Ferflogo/birds_gst/README.md

Birds Network Ground Station Terminal, SETECLab's implementation
============

### Most recent version of this repository can be found in: ###

* [GitHub](https://github.com/Setec-Lab/birds_gst)

### What is this repository for? ###

* This repository was created to develop the SETECLab's implementation of the Birds Network Ground Station Terminal. 

### Board v2.7

* [Schematic](https://github.com/Setec-Lab/birds_gst/blob/dev/docs/GST_PCB_v2.7.pdf)
* [BOM](https://github.com/Setec-Lab/birds_gst/blob/dev/docs/Partlist_for_GST_PCB_v2.7.pdf)
* [Guide](https://github.com/Setec-Lab/birds_gst/blob/dev/docs/Guide_to_use_GST_PCB.pdf)

### DS18B20 Temp. Sensor

* [Datasheet](https://cdn.sparkfun.com/datasheets/Sensors/Temp/DS18B20.pdf) 
* [Implementation example](https://create.arduino.cc/projecthub/TheGadgetBoy/ds18b20-digital-temperature-sensor-and-arduino-9cc806)

### LM2830XMF/NOPB Step Down DC/DC Regulator

* [Datasheet](https://pdf1.alldatasheet.com/datasheet-pdf/view/753277/TI/LM2830XMF/NOPB.html)

### RF98
* [Datasheet](https://datasheetspdf.com/pdf-file/748004/HOPERF/RF98/1)

### Enclousure

### How do I get set up? ###

* Install Git
* Install Arduino IDE
* Install ESP32 Board in the Arduino Boards Manager
Open Arduino IDE, then Select `Tools`->`Board:`->`Boards Manager...`
Search `ESP32` and install it.
* Install Heltec ESP32 Library in the Arduino Library Manager
Open Arduino IDE, then Select `Sketch`->`Include Library`->`Manage Libraries...`
Search `Heltec ESP32` and install it.
* Install Adafruit MQTT Library in the Arduino Library Manager
Open Arduino IDE, then Select `Sketch`->`Include Library`->`Manage Libraries...`
Search `Adafruit MQTT` and install it.
* Install Adafruit MCP9600 Library in the Arduino Library Manager
Open Arduino IDE, then Select `Sketch`->`Include Library`->`Manage Libraries...`
Search `Adafruit MCP9600 Library` and install it.

### Contribution guidelines ###

* If you want to propose a review or need to modify the code for any reason first clone this [repository](https://github.com/DeltaLabo/caminos) in your PC and create a new branch for your changes. Once your changes are complete and fully tested ask the administrator permission to push this new branch into the source.
* If you just want to do local changes instead you can download a zip version of the repository and do all changes locally in your PC. 

### Who do I talk to? ###

* [Juan J. Rojas](mailto:juan.rojas@itcr.ac.cr)
* [Ian Coberly](mailto:cobjim28@gmail.com)
