Ferflogo/birds_gst/docs/GST_PCB_v2.7.pdf

0.1u | 22n

3.3uH

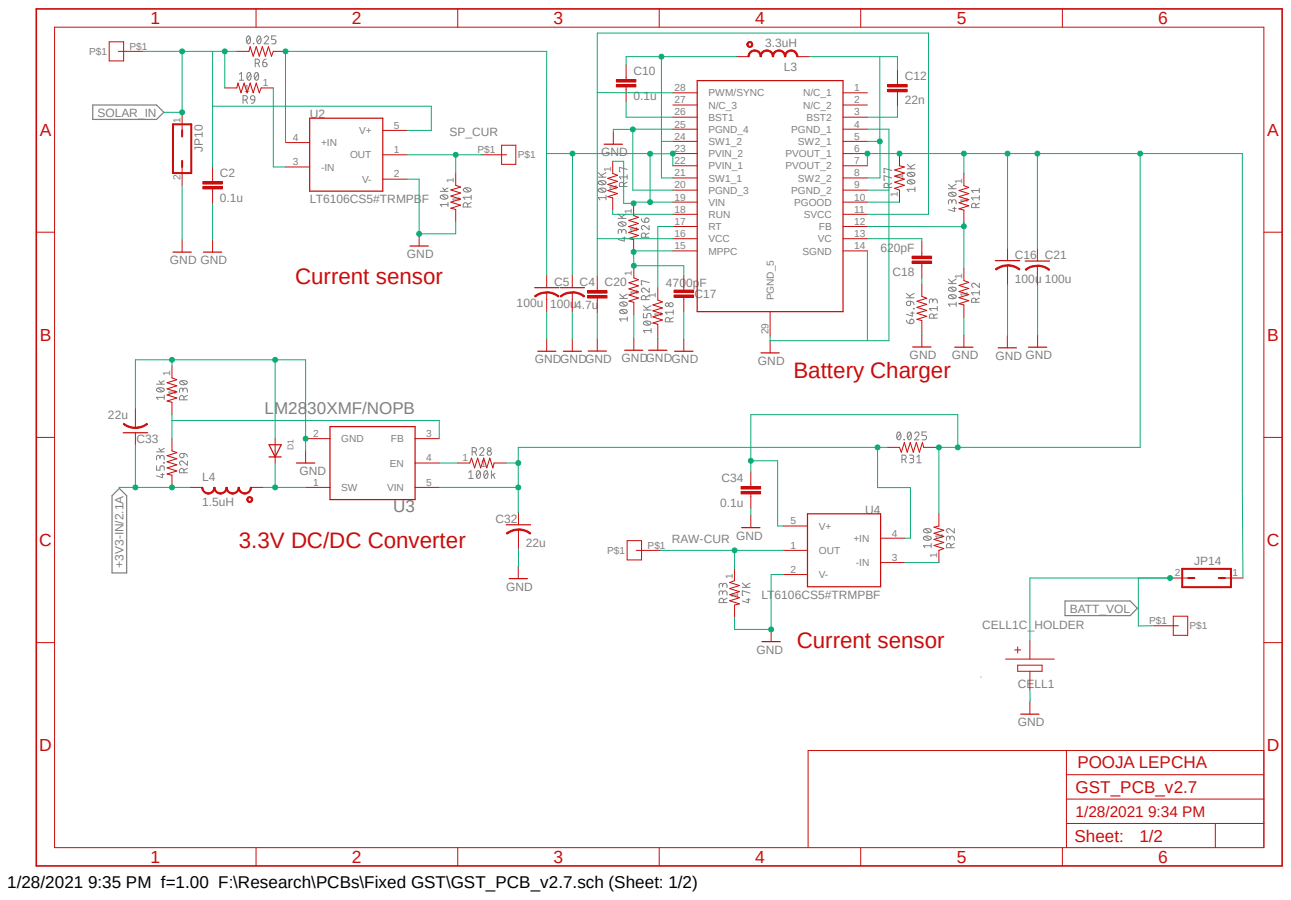
[picture p1: page 1]

1/28/2021 9:35 PM f=1.00 F:\Research\PCBs\Fixed GST\GST_PCB_v2.7.sch (Sheet: 1/2)

# Flash Memory

A

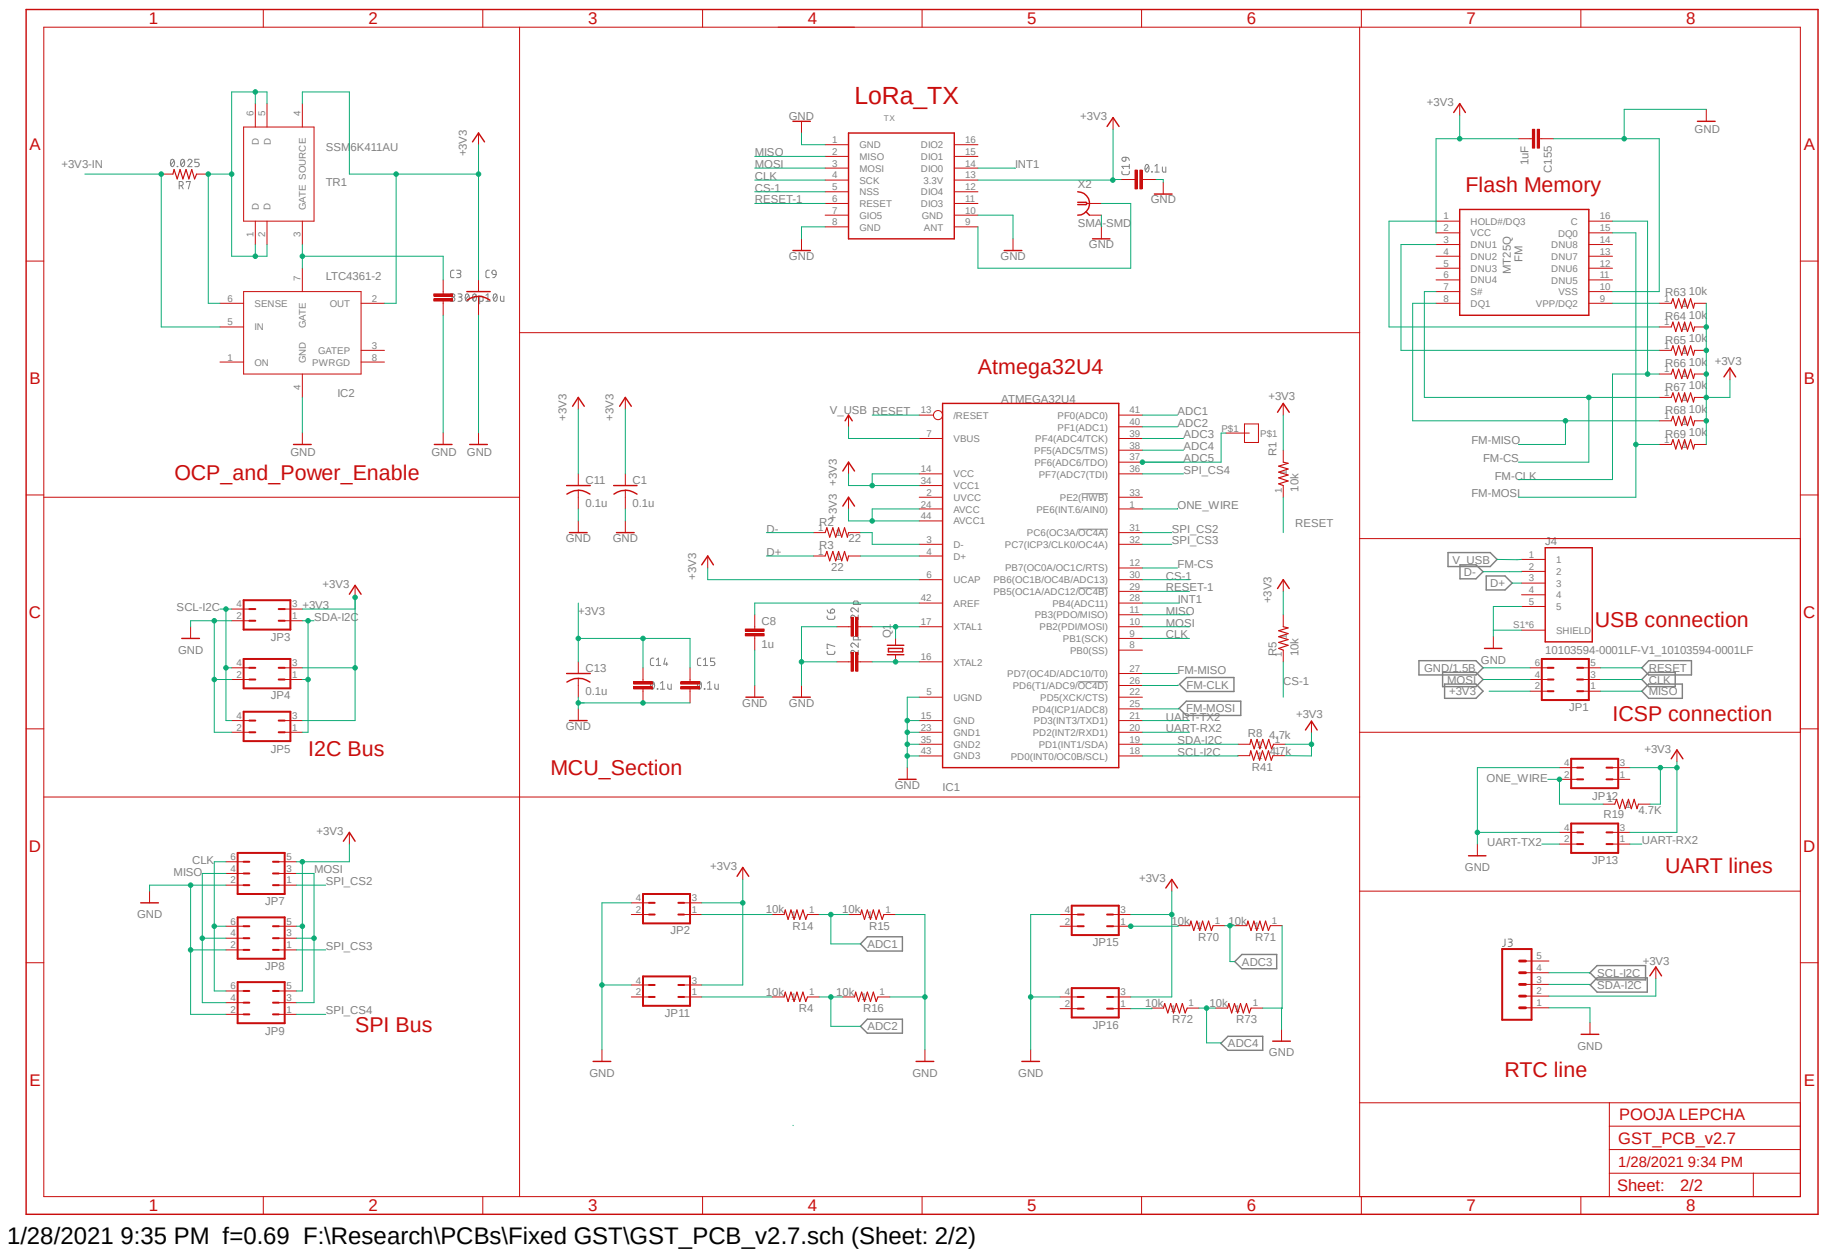
[picture p2: page 2]

LoRa_TX

1/28/2021 9:35 PM f=0.69 F:\Research\PCBs\Fixed GST\GST_PCB_v2.7.sch (Sheet: 2/2)
