Ferflogo/birds_gst/docs/Guide_to_use_GST_PCB.pdf

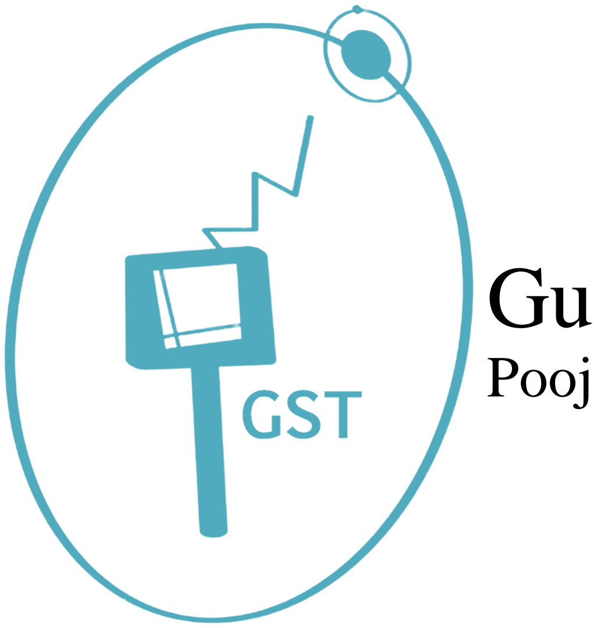
[picture p3: figure]

# Guide to Use GST PCB

## Pooja Lepcha

# What makes the GST PCB?

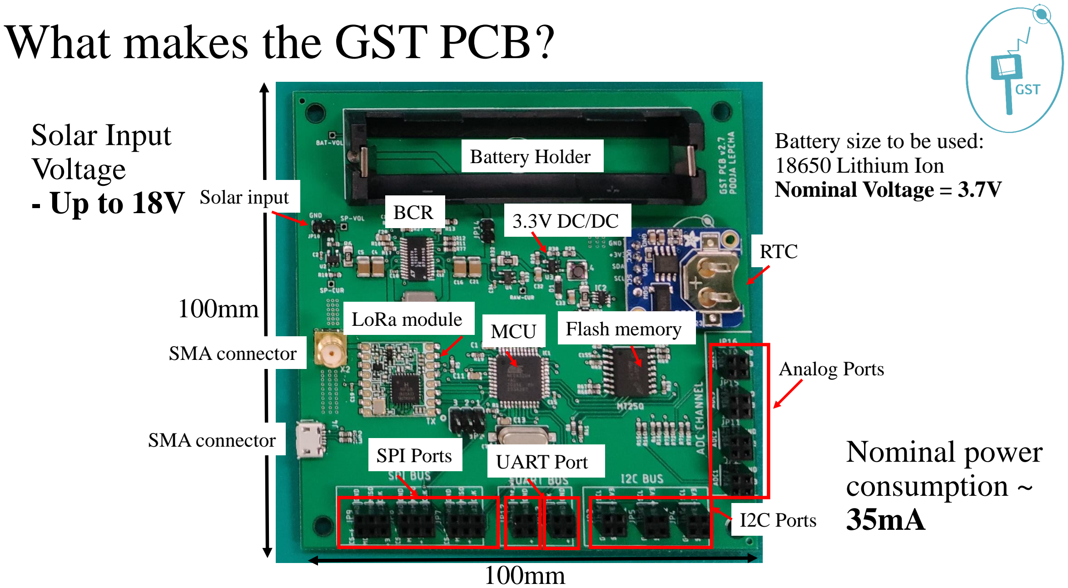
[picture p4: page 2]

100mm

100mm

Analog Ports

I2C Ports

UART Port SPI Ports

RTC

MCU LoRa module

BCR

Battery Holder

Flash memory

Solar input

Nominal power
consumption ~
35mA

3.3V DC/DC

Solar Input
Voltage
- Up to 18V

SMA connector

SMA connector

Battery size to be used:
18650 Lithium Ion
Nominal Voltage = 3.7V

# Lets look deeper…

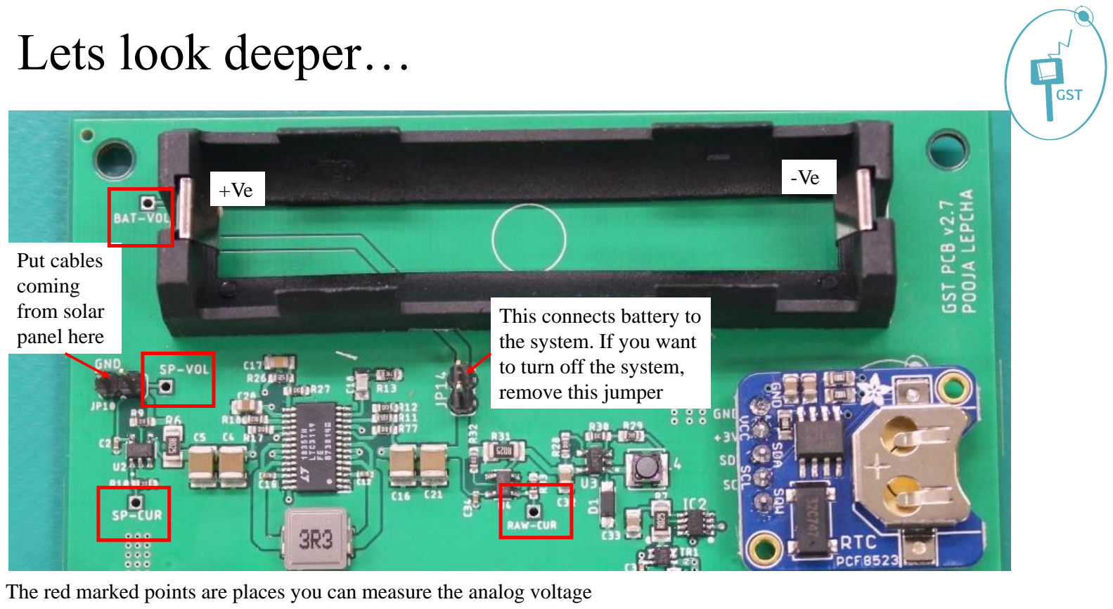
[picture p5: page 3]

Put cables
coming
from solar
panel here

-Ve

This connects battery to
the system. If you want
to turn off the system,
remove this jumper

+Ve

The red marked points are places you can measure the analog voltage

Lets look deeper… | These are boot loading pins for Atmega,
| the bootloader is already uploaded. Check next page for pin assignment

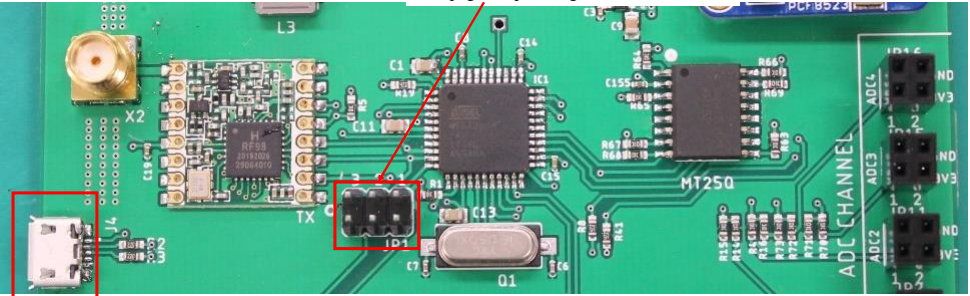
[picture p6: figure]

You can program the atmega directly from here.

# Boot loaded Pin Assignment

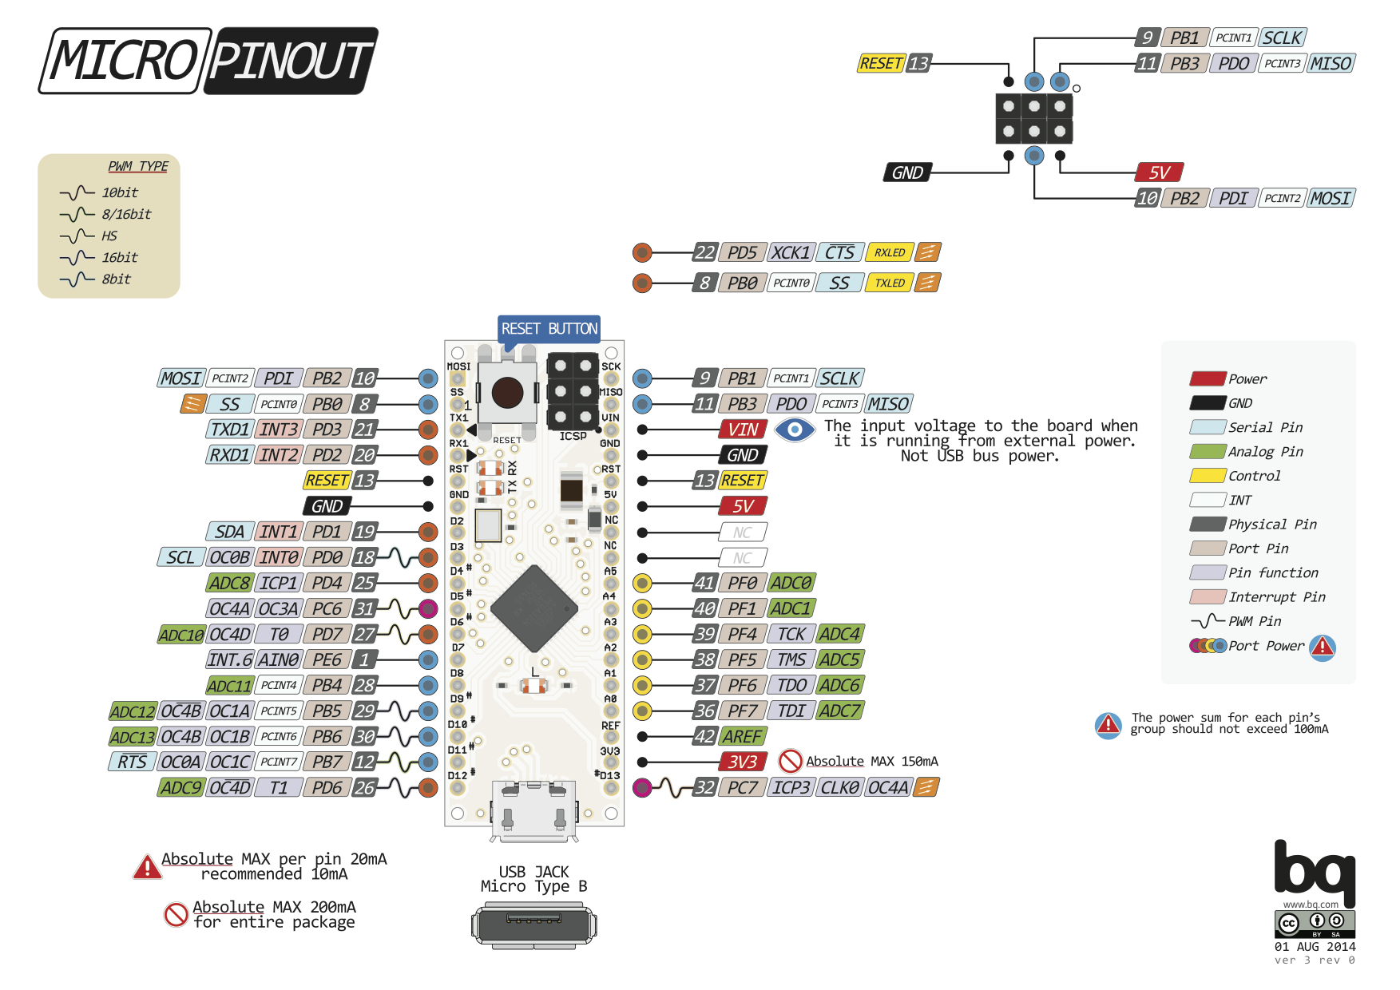
[picture p7: figure]

Please use this pin
assignment for the
Atmega. It follows
the Arduino Micro
Pin assignment

# Lets look deeper…

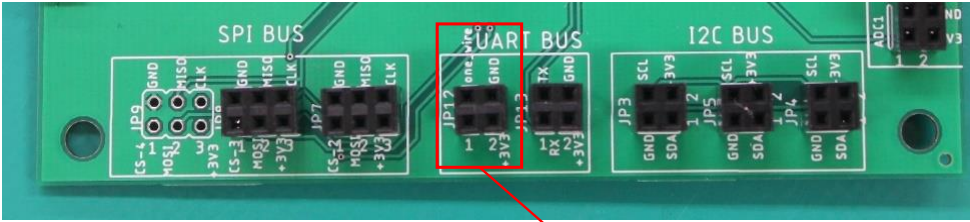
[picture p8: figure]

Please check the silk print for the pin assignment. This one is not UART pin. It is for connecting one wire temperature sensor (DS18B20). The circuit for getting the data has already been implemented.
https://create.arduino.cc/projecthub/TheGadgetBoy/ds18b20-digital-temperature-sensor-and-arduino-9cc806

# Lets look deeper…

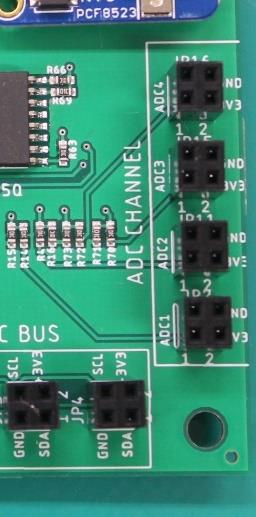
[picture p9: figure]

Pin 1 of every ADC port is fed to the atmega for taking analog measurements. There is a voltage divider for every ADC channel. Make sure to multiply the voltage by 2

You can even connect using jumpers the analog readings from current and voltage measurements from the third page to these ports to measure solar panel voltage, battery voltage, solar panel current and raw current
