Ferflogo/birds_gst/(commit log)

2021-04-10 things from Pooja
    [Partlist for GST PCB v2.7.xlsx]
2021-04-10 Changes in docs
    [Partlist for GST PCB v2.7.xlsx, Partlist_for_GST_PCB_v2.7.xlsx]
2021-04-15 Update README.md
    Se agregó el datasheet de algunos componentes del board
